clnrp/anambe_azul_pcb/anambe_azul.brd

## EAGLE design anambe_azul.brd (2021-04-27)

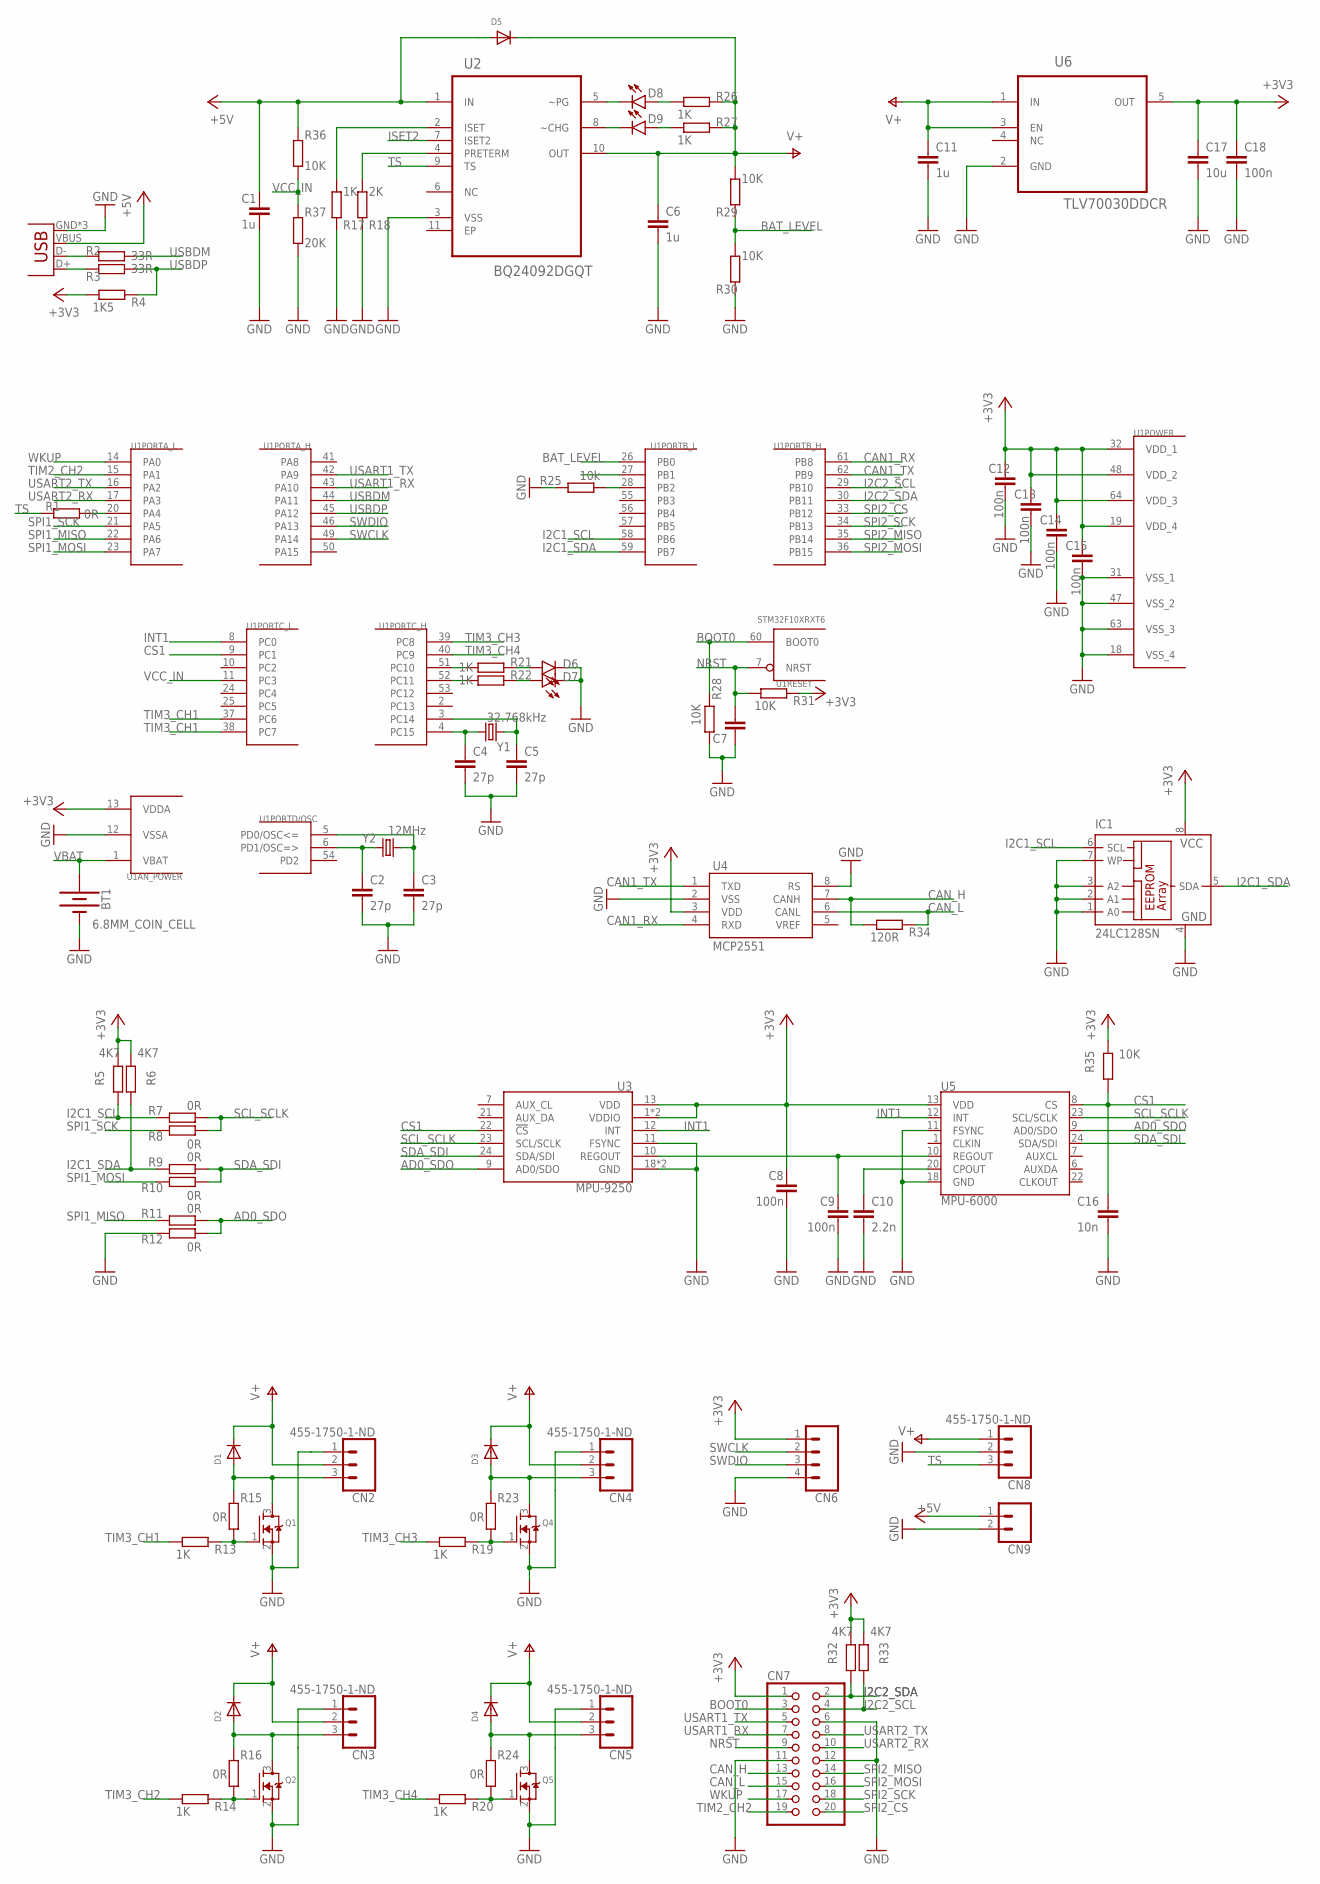
[picture p1: schematic anambe_azul.sch]

Parts:
BT1: 6.8MM_COIN_CELL; BATTCON-6.8MM
C1, C6, C11: 1u; C0603
C2, C3, C4, C5: 27p; C0603
C7: C-EUC0603; C0603
C8, C9, C12, C13, C14, C15, C18: 100n; C0603
C10: 2.2n; C0603
C16: 10n; C0603
C17: 10u; C0603
CN1: SPARKFUN-CONNECTORS_USB-MICROB
CN2, CN3, CN4, CN5, CN8: 455-1750-1-ND; 1X03
CN6: CONN_04; 1X04
CN7: PINHD-2X10; 2X10
CN9: CONN_02; 1X02
D1, D2, D3, D4, D5: DIODESOD-123; SOD-123
D6, D7, D8, D9: LED0603; LED-0603
IC1: 24LC128SN; SO-08
Q1, Q2, Q4, Q5: MOSFET-NREFLOW; SOT23
R1, R7, R8, R9, R10, R11, R12, R15, R16, R23, R24: 0R; R0603
R2, R3: 33R; R0603
R4: 1K5; R0603
R5, R6, R32, R33: 4K7; R0603
R13, R14, R17, R19, R20, R21, R22, R26, R27: 1K; R0603
R18: 2K; R0603
R25: 10k; R0603
R28, R29, R30, R31, R35, R36: 10K; R0603
R34: 120R; R0603
R37: 20K; R0603
U1: STM32F10XRXT6; TQFP64
U2: BQ24092DGQT; SOP50P490X110-11N
U3: MPU-9250; QFN24-3X3
U4: MCP2551; SO08
U5: MPU-6000; QFN-24-EP
U6: TLV70030DDCR; SOT95P280X110-5N
Y1: 32.768kHz; CRYSTAL-PTH-2X6-CYL
Y2: 12MHz; HC49UP

Connections:
+3V3: C8.1, C12.1, C13.1, C14.1, C15.1, C17.1, C18.1, CN6.1, CN7.1, IC1.8 (VCC), R4.1, R5.1, R6.1, R31.2, R32.1, R33.1, R35.2, U1.13 (VDDA), U1.19 (VDD_4), U1.32 (VDD_1), U1.48 (VDD_2), U1.64 (VDD_3), U3.1 (VDDIO), U3.8 (VDDIO), U3.13 (VDD), U4.3 (VDD), U5.13 (VDD), U6.5 (OUT)
+5V: C1.1, CN1.VBUS, CN9.1, D5.A, R36.2, U2.1 (IN)
AD0_SDO: R11.1, R12.1, U3.9 (AD0/SDO), U5.9 (AD0/SDO)
BAT_LEVEL: R29.2, R30.1, U1.26 (PB0)
BOOT0: CN7.3, R28.2, U1.60 (BOOT0)
CAN1_RX: U1.61 (PB8), U4.4 (RXD)
CAN1_TX: U1.62 (PB9), U4.1 (TXD)
CAN_H: CN7.13, R34.1, U4.7 (CANH)
CAN_L: CN7.15, R34.2, U4.6 (CANL)
CS1: C16.1, R35.1, U1.9 (PC1), U3.22 (!CS), U5.8 (CS)
GND: BT1.-, C1.2, C2.2, C3.2, C4.2, C5.2, C6.2, C7.1, C8.2, C9.2, C10.2, C11.2, C12.2, C13.2, C14.2, C15.2, C16.2, C17.2, C18.2, CN1.GND, CN1.MT1 (GND), CN1.MT2 (GND), CN2.1, CN3.1, CN4.1, CN5.1, CN6.4, CN7.6, CN7.11, CN7.12, CN8.2, CN9.2, D6.C, D7.C, IC1.1 (A0), IC1.2 (A1), IC1.3 (A2), IC1.4 (GND), IC1.7 (WP), Q1.2 (S), Q2.2 (S), Q4.2 (S), Q5.2 (S), R12.2, R17.2, R18.2, R25.2, R28.1, R30.2, R37.2, U1.12 (VSSA), U1.18 (VSS_4), U1.31 (VSS_1), U1.47 (VSS_2), U1.63 (VSS_3), U2.3 (VSS), U3.11 (FSYNC), U3.18 (GND), U3.20 (GND), U4.2 (VSS), U4.8 (RS), U5.11 (FSYNC), U5.18 (GND), U6.2 (GND)
I2C1_SCL: IC1.6 (SCL), R5.2, R7.2, U1.58 (PB6)
I2C1_SDA: IC1.5 (SDA), R6.2, R9.2, U1.59 (PB7)
I2C2_SCL: CN7.4, R33.2, U1.29 (PB10)
I2C2_SDA: CN7.2, R32.2, U1.30 (PB11)
INT1: U1.8 (PC0), U3.12 (INT), U5.12 (INT)
ISET2: U1.27 (PB1), U2.7 (ISET2)
unnamed: C2.1, U1.6 (PD1/OSC=>), Y2.1
unnamed: CN1.D+, R3.1
unnamed: C3.1, U1.5 (PD0/OSC<=), Y2.2
unnamed: Q1.1 (G), R13.2, R15.1
unnamed: CN1.D-, R2.1
unnamed: C4.1, U1.4 (PC15), Y1.2
unnamed: C5.1, U1.3 (PC14), Y1.1
unnamed: CN2.3, D1.A, Q1.3 (D), R15.2
unnamed: Q4.1 (G), R19.2, R23.1
unnamed: CN4.3, D3.A, Q4.3 (D), R23.2
unnamed: Q2.1 (G), R14.2, R16.1
unnamed: C10.1, U5.20 (CPOUT)
unnamed: C9.1, U3.10 (REGOUT), U5.10 (REGOUT)
unnamed: D9.C, U2.8 (~CHG)
unnamed: CN3.3, D2.A, Q2.3 (D), R16.2
unnamed: Q5.1 (G), R20.2, R24.1
unnamed: CN5.3, D4.A, Q5.3 (D), R24.2
unnamed: R25.1, U1.28 (PB2)
unnamed: D9.A, R27.1
unnamed: D8.A, R26.1
unnamed: D8.C, U2.5 (~PG)
unnamed: R17.1, U2.2 (ISET)
unnamed: R18.1, U2.4 (PRETERM)
unnamed: R21.1, U1.51 (PC10)
unnamed: R22.1, U1.52 (PC11)
unnamed: D6.A, R21.2
unnamed: D7.A, R22.2
unnamed: R1.1, U1.20 (PA4)
NRST: C7.2, CN7.9, R31.1, U1.7 (NRST)
SCL_SCLK: R7.1, R8.1, U3.23 (SCL/SCLK), U5.23 (SCL/SCLK)
SDA_SDI: R9.1, R10.1, U3.24 (SDA/SDI), U5.24 (SDA/SDI)
SPI1_MISO: R11.2, U1.22 (PA6)
SPI1_MOSI: R10.2, U1.23 (PA7)
SPI1_SCK: R8.2, U1.21 (PA5)
SPI2_CS: CN7.20, U1.33 (PB12)
SPI2_MISO: CN7.14, U1.35 (PB14)
SPI2_MOSI: CN7.16, U1.36 (PB15)
SPI2_SCK: CN7.18, U1.34 (PB13)
SWCLK: CN6.2, U1.49 (PA14)
SWDIO: CN6.3, U1.46 (PA13)
TIM2_CH2: CN7.19, U1.15 (PA1)
TIM3_CH1: R13.1, U1.37 (PC6)
TIM3_CH2: R14.1, U1.38 (PC7)
TIM3_CH3: R19.1, U1.39 (PC8)
TIM3_CH4: R20.1, U1.40 (PC9)
TS: CN8.3, R1.2, U2.9 (TS)
USART1_RX: CN7.7, U1.43 (PA10)
USART1_TX: CN7.5, U1.42 (PA9)
USART2_RX: CN7.10, U1.17 (PA3)
USART2_TX: CN7.8, U1.16 (PA2)
USBDM: R2.2, U1.44 (PA11)
USBDP: R3.2, R4.2, U1.45 (PA12)
V+: C6.1, C11.1, CN2.2, CN3.2, CN4.2, CN5.2, CN8.1, D1.C, D2.C, D3.C, D4.C, D5.C, R26.2, R27.2, R29.1, U2.10 (OUT), U6.1 (IN), U6.3 (EN)
VBAT: BT1.+, U1.1 (VBAT)
VCC_IN: R36.1, R37.1, U1.11 (PC3)
WKUP: CN7.17, U1.14 (PA0)

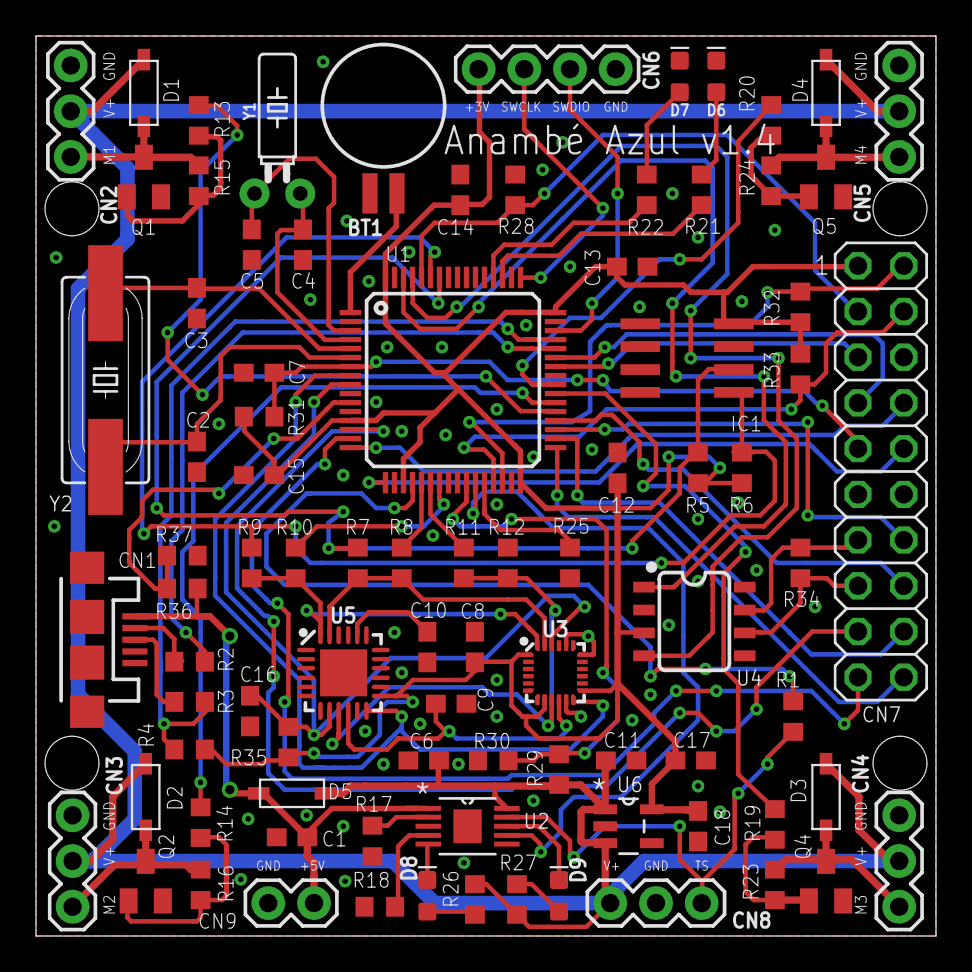
[picture p2: board anambe_azul.brd from above]

Board: 2 copper layers, 50.0 x 50.0 mm, 87 parts (0 on the bottom side), 73 nets.
